JustinJiang11/Magnetic_Tactile_Sensor/circuits/circuits design.jpg

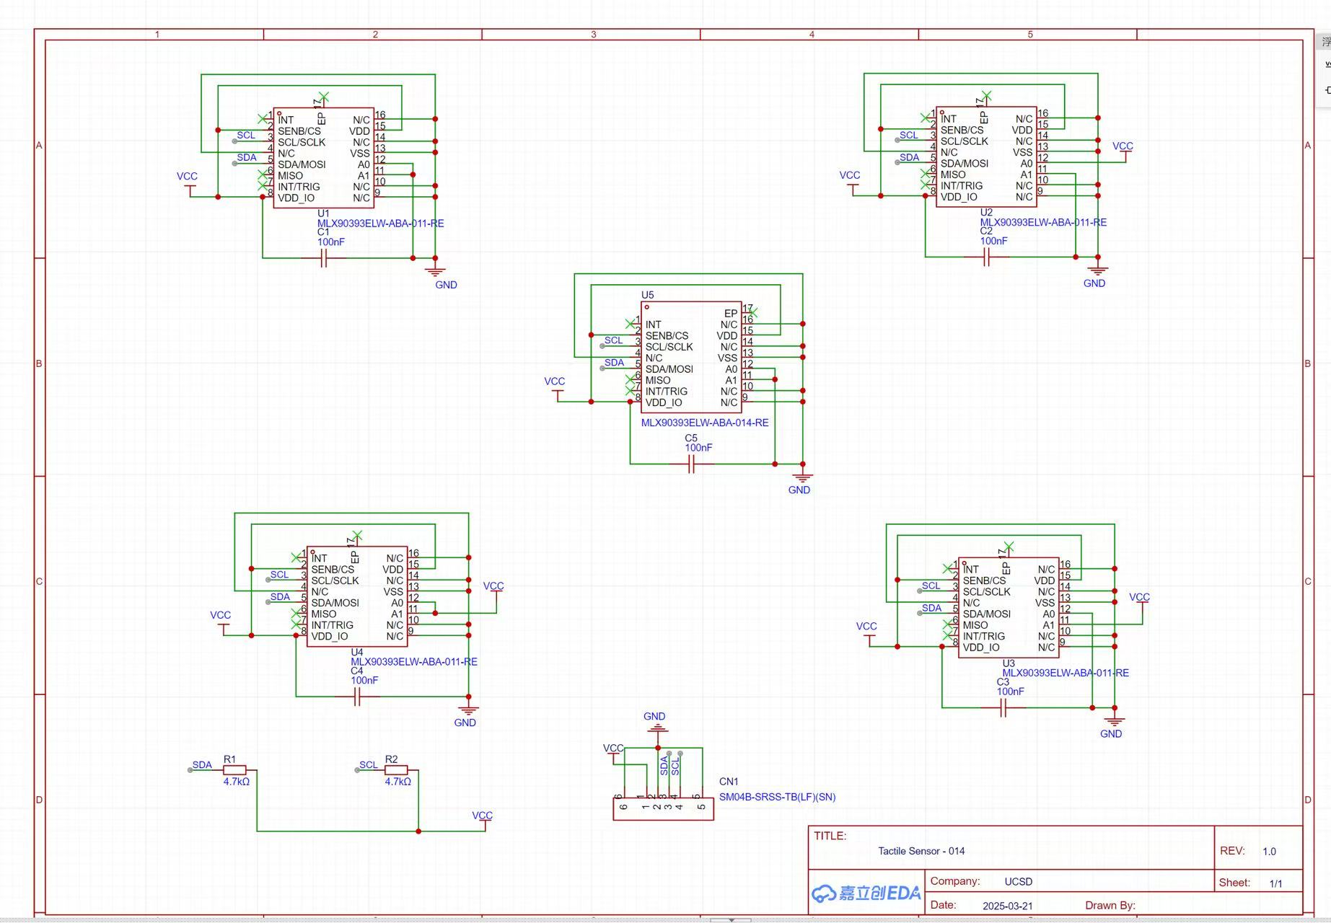
circuits/circuits design.jpg
