JustinJiang11/Magnetic_Tactile_Sensor/circuits/pcb.png

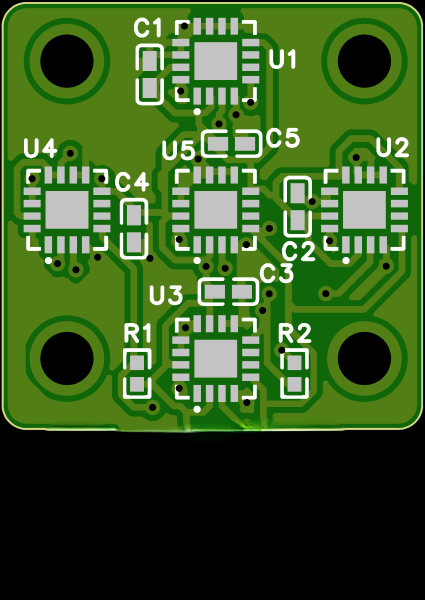
circuits/pcb.png
