JustinJiang11/Magnetic_Tactile_Sensor/model/loss_plots/fold_1_curve.png

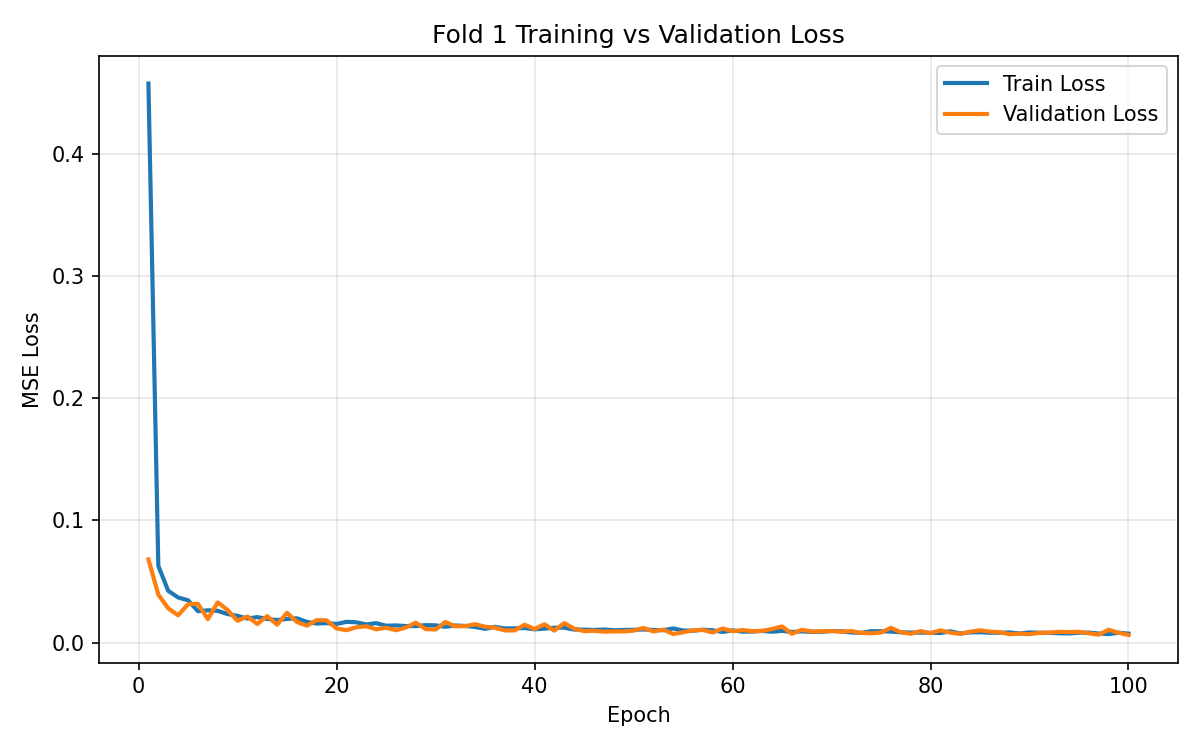
model/loss_plots/fold_1_curve.png
