JustinJiang11/Magnetic_Tactile_Sensor/model/loss_plots/fold_4_curve.png

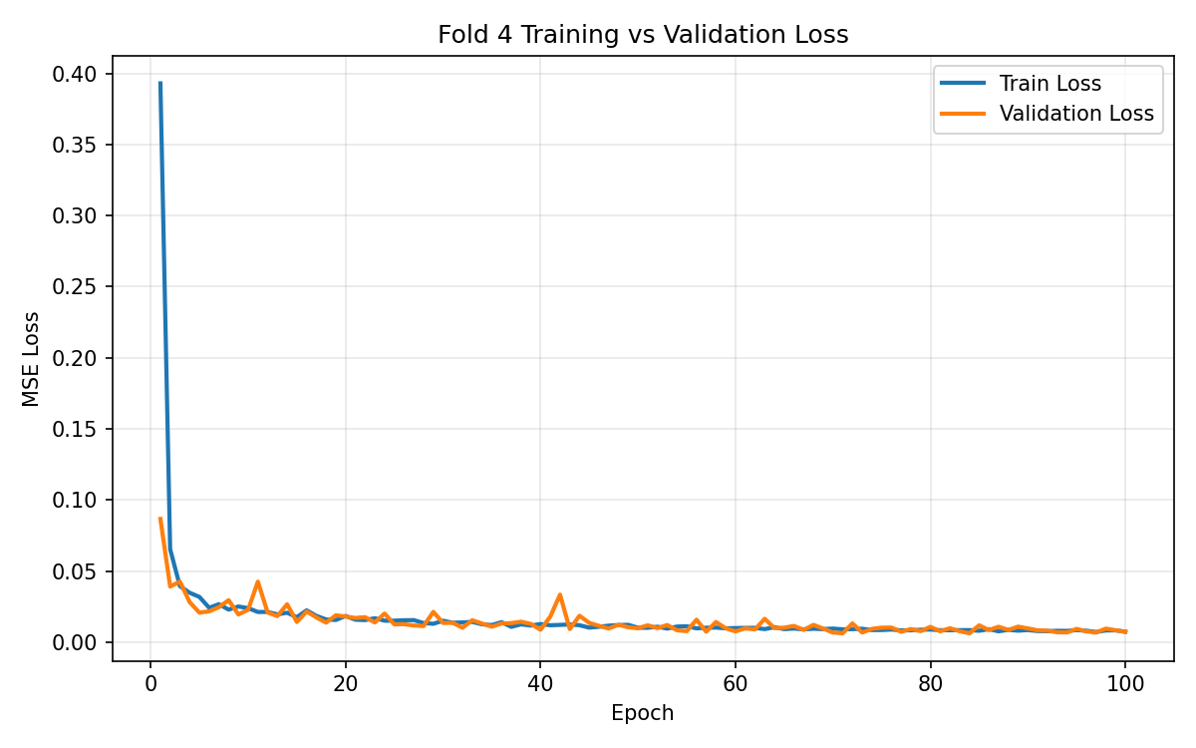
model/loss_plots/fold_4_curve.png
