JustinJiang11/Magnetic_Tactile_Sensor/visualization/terminal visualization.jpg

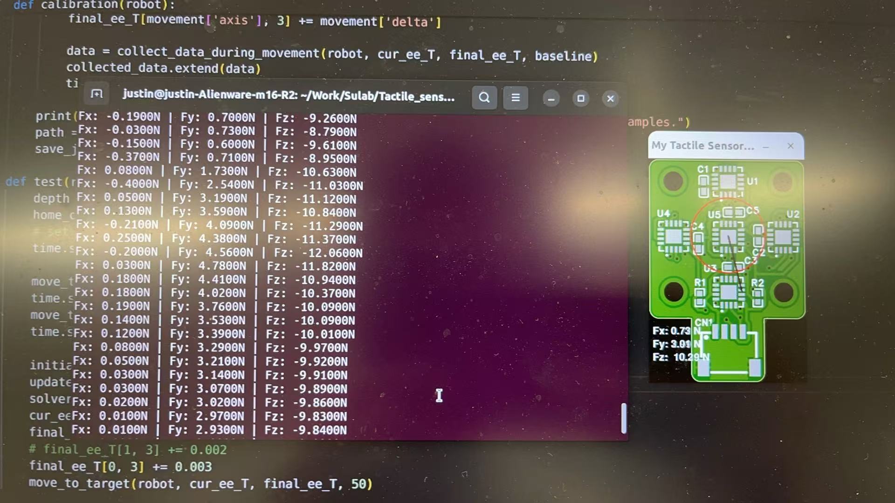
visualization/terminal visualization.jpg
