JustinJiang11/Magnetic_Tactile_Sensor/circuits/BOM_Tactile_PCB1.xlsx

No. | Quantity | Comment | Designator | Footprint | Value | Manufacturer Part | Manufacturer | Supplier Part | Supplier
1 | 5 | 100nF | C1,C2,C3,C4,C5 | C0402 | 100nF | CL05B104KB54PNC | SAMSUNG(三星) | C307331 | LCSC
2 | 1 | SM04B-SRSS-TB(LF)(SN) | CN1 | CONN-SMD_4P-P1.00_SM04B-SRSS-TB-LF-SN |  | SM04B-SRSS-TB(LF)(SN) | JST | C160404 | LCSC
3 | 2 | 4.7kΩ | R1,R2 | R0402 | 4.7kΩ | 0402WGF2201TCE | UNI-ROYAL(厚声) |  | LCSC
4 | 4 | MLX90393ELW-ABA-011-RE | U1,U2,U3,U4 | VFQFN-16_L3.0-W3.0-P0.50-BL-EP |  | MLX90393ELW-ABA-011-RE | Melexis(比利时迈来芯) | C2654971 | LCSC
5 | 1 | MLX90393ELW-ABA-012-RE | U5 | VFQFN-16_L3.0-W3.0-P0.50-BL-EP |  | MLX90393ELW-ABA-012-RE | Melexis(比利时迈来芯) | C3716135 | LCSC
