JustinJiang11/Magnetic_Tactile_Sensor/parts/mid.STL

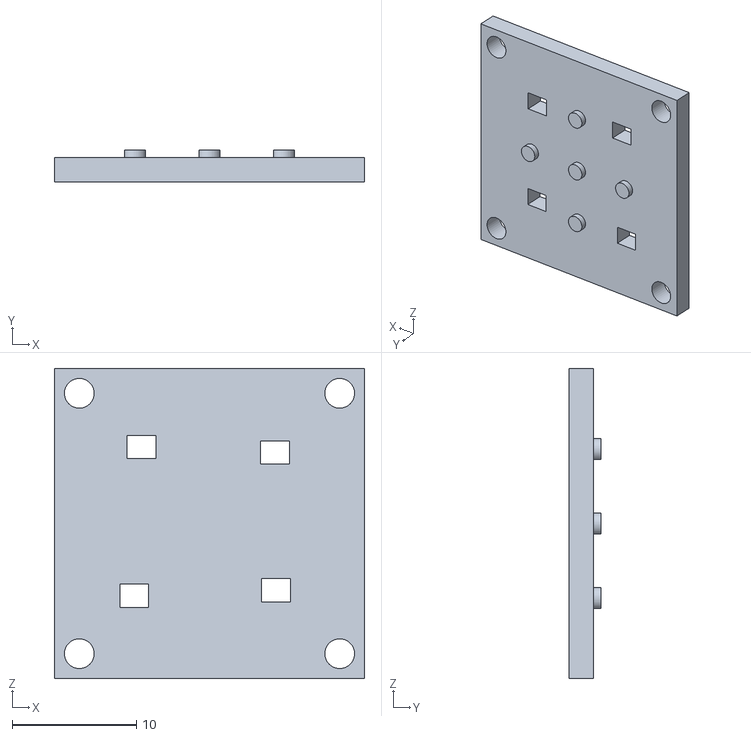
[picture p15: CAD file, 2026-05-16]
parts/mid.STL
25.0 x 2.60 x 25.0
