JustinJiang11/Magnetic_Tactile_Sensor/parts/bottom23.STL

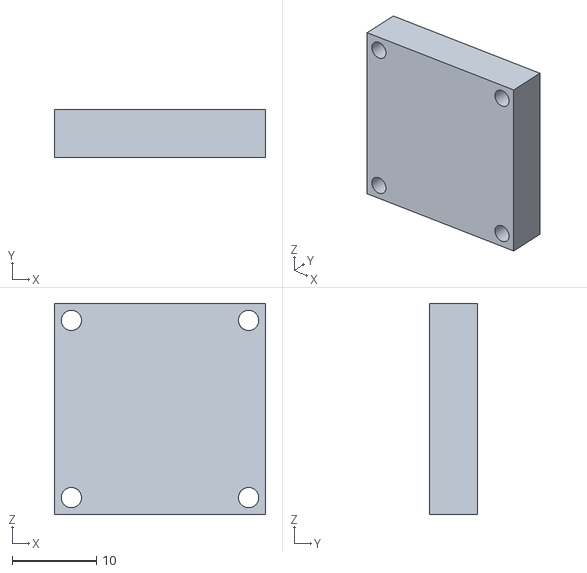
[picture p16: CAD file, 2026-05-16]
parts/bottom23.STL
25.0 x 5.70 x 25.0
