JustinJiang11/Magnetic_Tactile_Sensor/parts/top23.STL

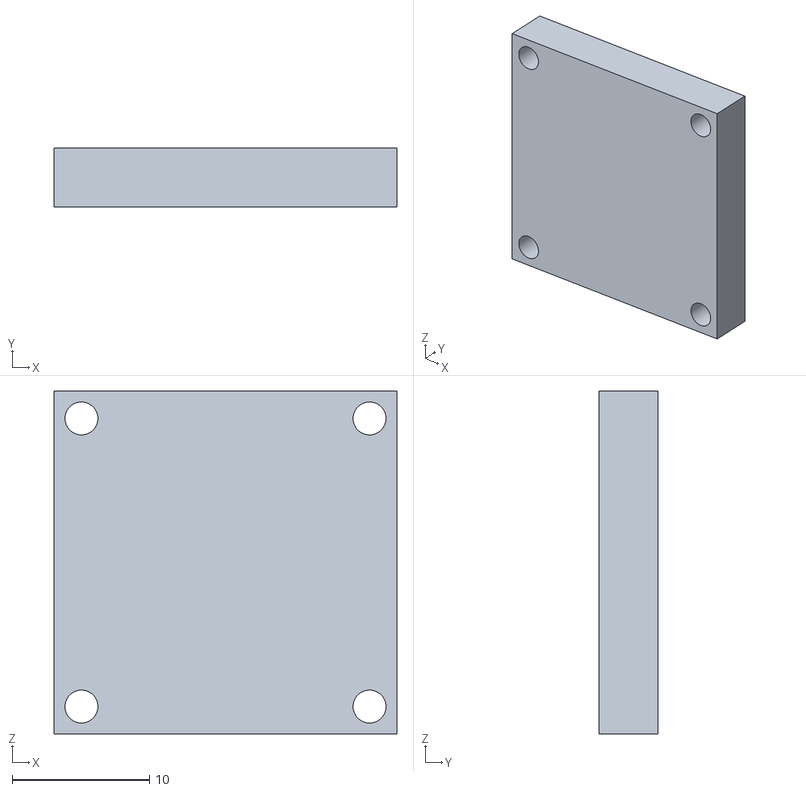
[picture p17: CAD file, 2026-05-16]
parts/top23.STL
25.0 x 4.30 x 25.0
