JustinJiang11/Magnetic_Tactile_Sensor/parts/finger_tip_v3.STEP

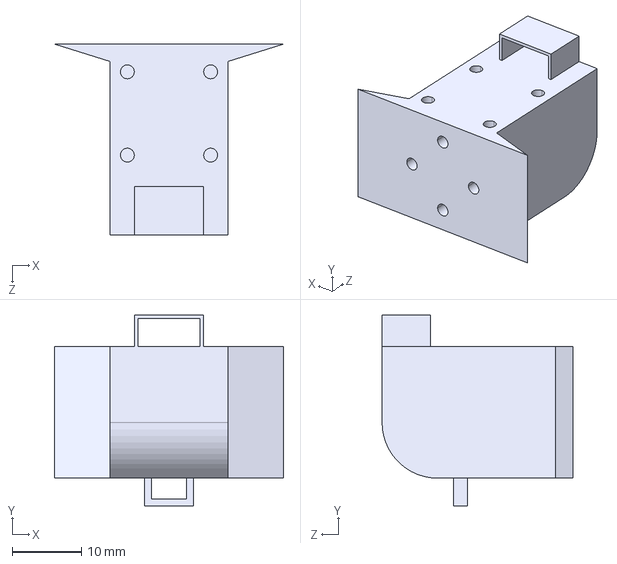
[picture p18: CAD file, 2026-05-16]
parts/finger_tip_v3.STEP
33.0 x 27.5 x 27.5 mm
