JustinJiang11/Magnetic_Tactile_Sensor/(commit log)

2026-05-15 arduino and pyproject
2026-05-16 circuits and parts
    [BOM_Tactile_PCB1.xlsx, PickAndPlace_PCB1.xlsx, bottom23.STL, finger_tip_v3.STEP, mid.STL, top23.STL]
2026-05-17 sensor image
2026-05-17 tactile sensor image
2026-05-17 Modify image size and update sensor description
    Updated image size in README and removed sensor description.
